HMS-RIC/Teensy-Breakout/README.md

# Teensy-Breakout
Breakout board for 2x Teensys. Fits into 19" rack. Brings many IO pins to front panel BNC connectors. Includes solenoid drivers and comparator-based lick detection with fixed hysteresis.

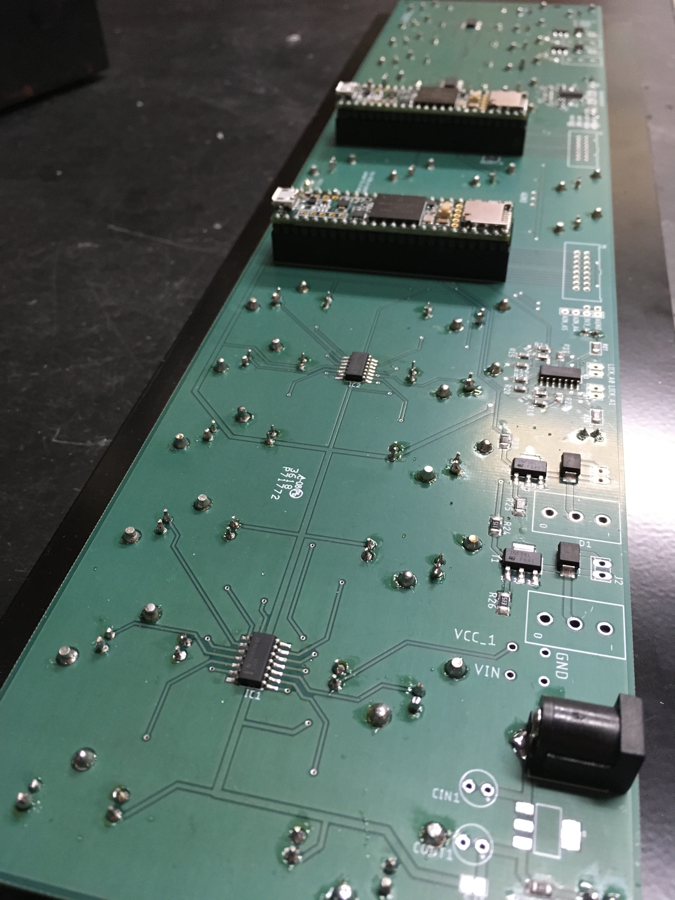
[picture p1: Photos/IMG_0949.JPG]

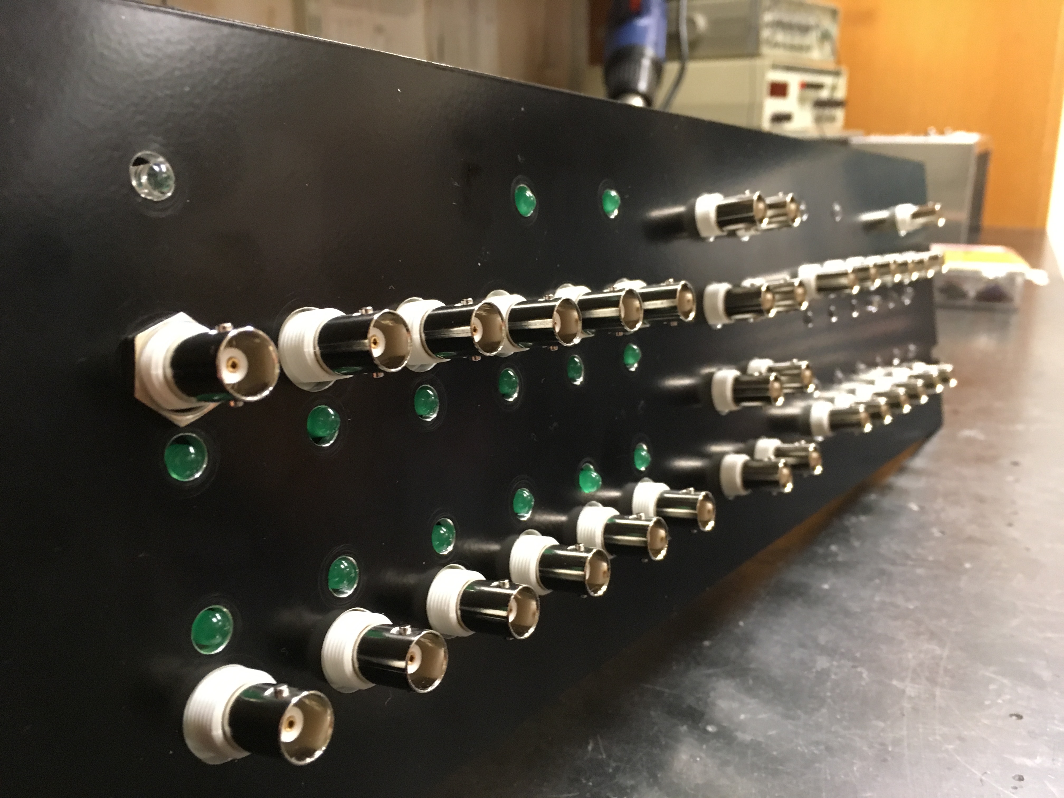
[picture p2: Photos/IMG_0952.JPG]
