HMS-RIC/Teensy-Breakout/TeensyBreakout_PinAssignments_1.pdf

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
1234

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
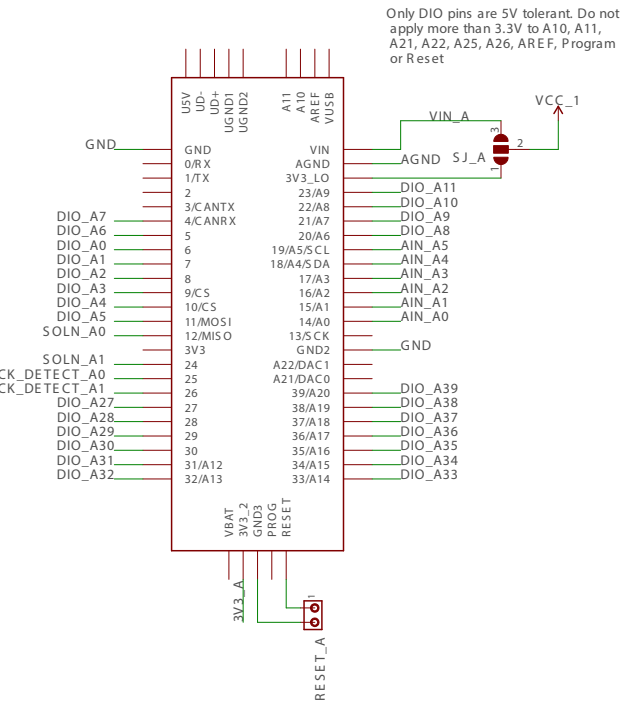
[picture p3: figure]
4 VUS B; UD+ UGND1; UGND2; GND3; VBAT

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
