HMS-RIC/Teensy-Breakout/Photos/IMG_0285.JPG

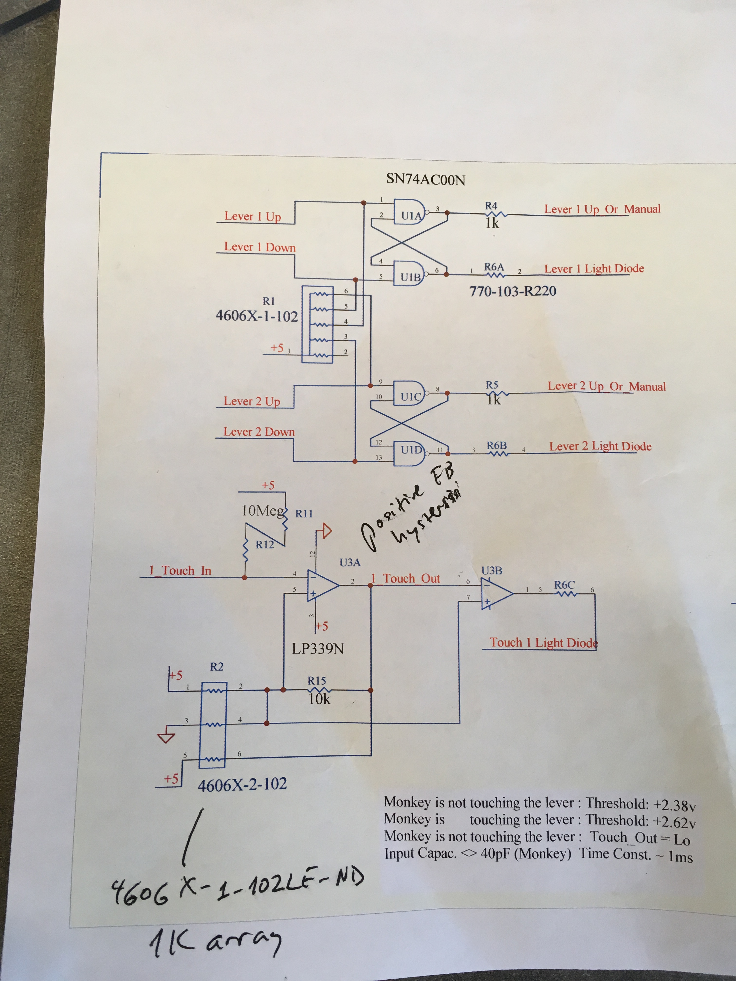
Photos/IMG_0285.JPG
