HMS-RIC/Teensy-Breakout/Photos/IMG_0286.JPG

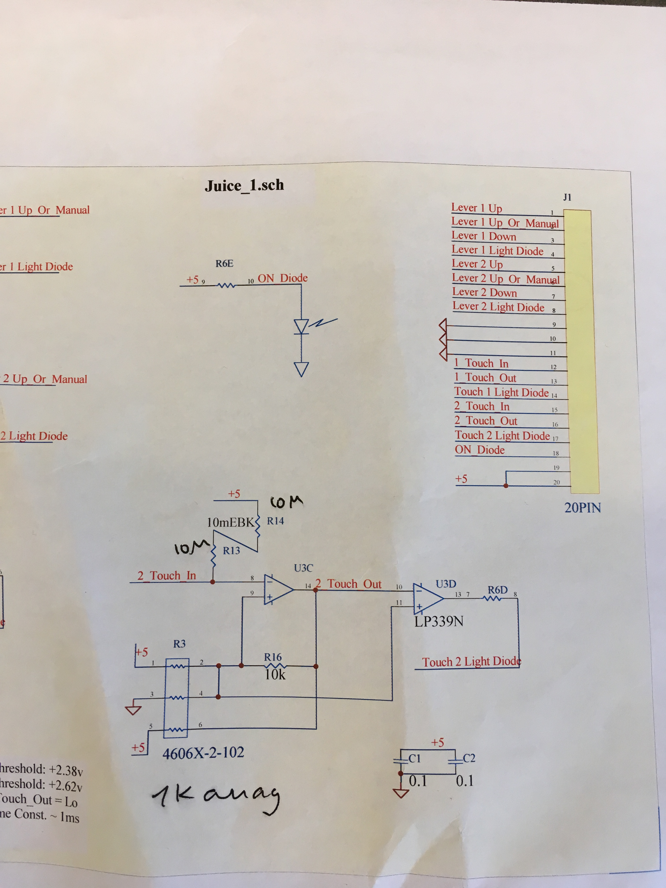
Photos/IMG_0286.JPG
