HMS-RIC/Teensy-Breakout/Photos/IMG_0287.JPG

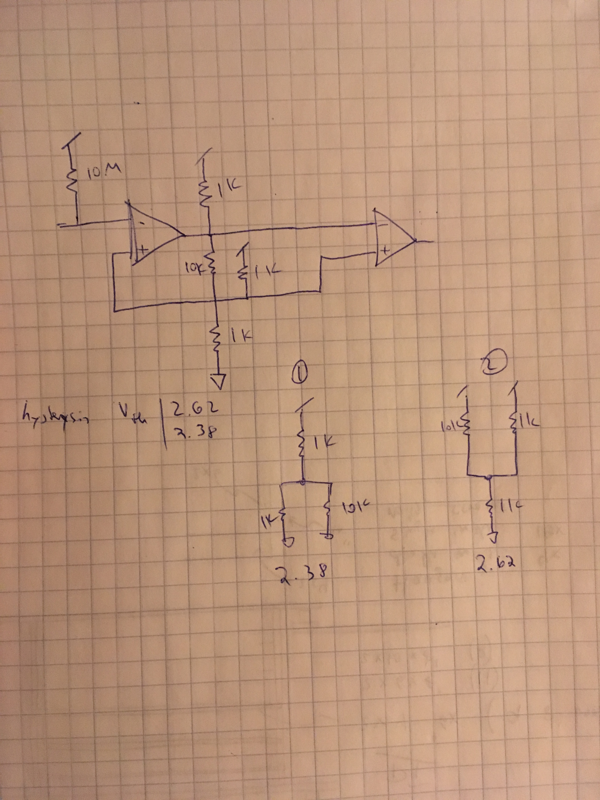
Photos/IMG_0287.JPG
