HMS-RIC/Teensy-Breakout/Photos/IMG_0288.JPG

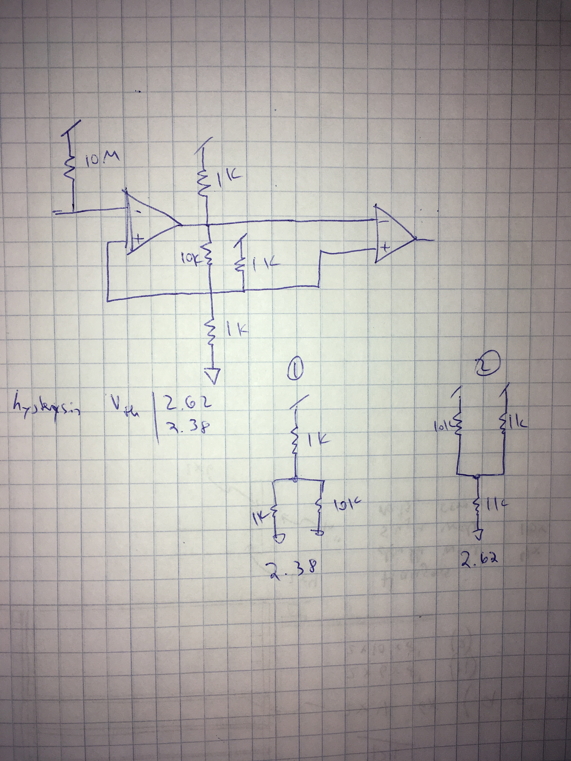
Photos/IMG_0288.JPG
