HMS-RIC/Teensy-Breakout/Photos/IMG_0944.JPG

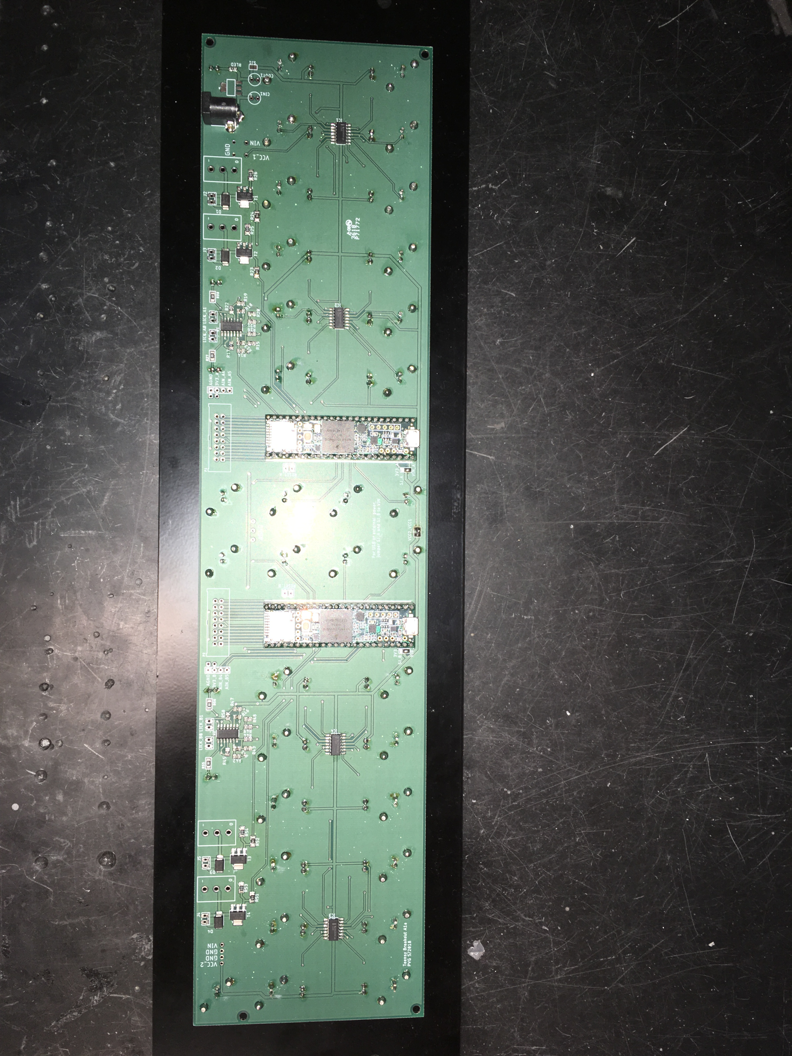
Photos/IMG_0944.JPG
