HMS-RIC/Teensy-Breakout/Photos/IMG_0945.JPG

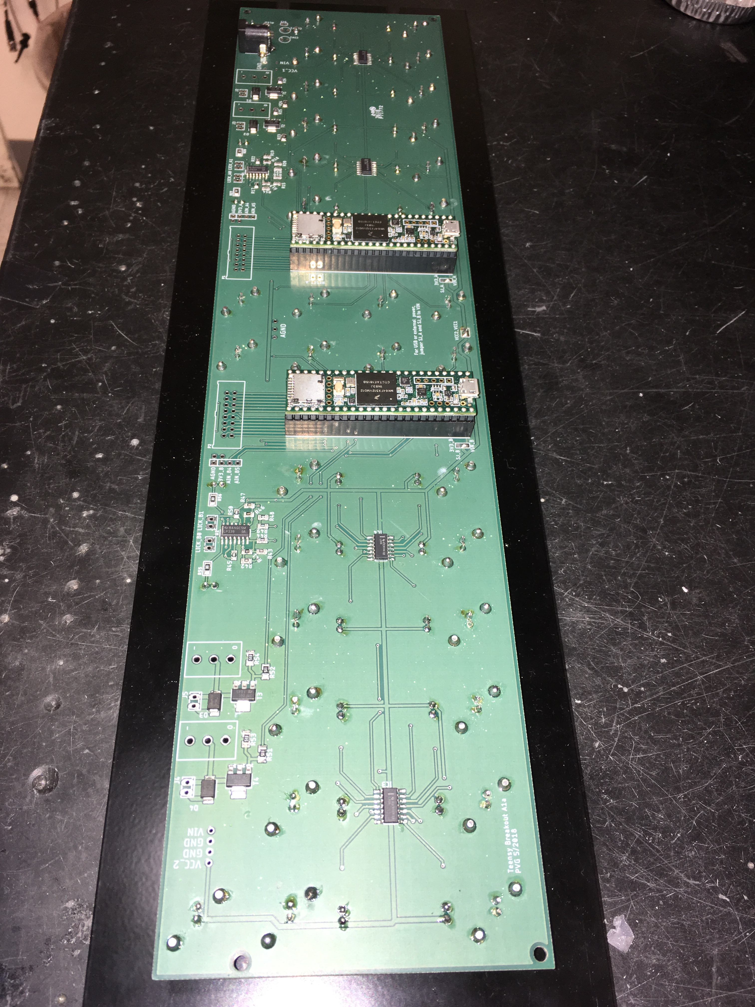
Photos/IMG_0945.JPG
