HMS-RIC/Teensy-Breakout/Photos/IMG_0946.JPG

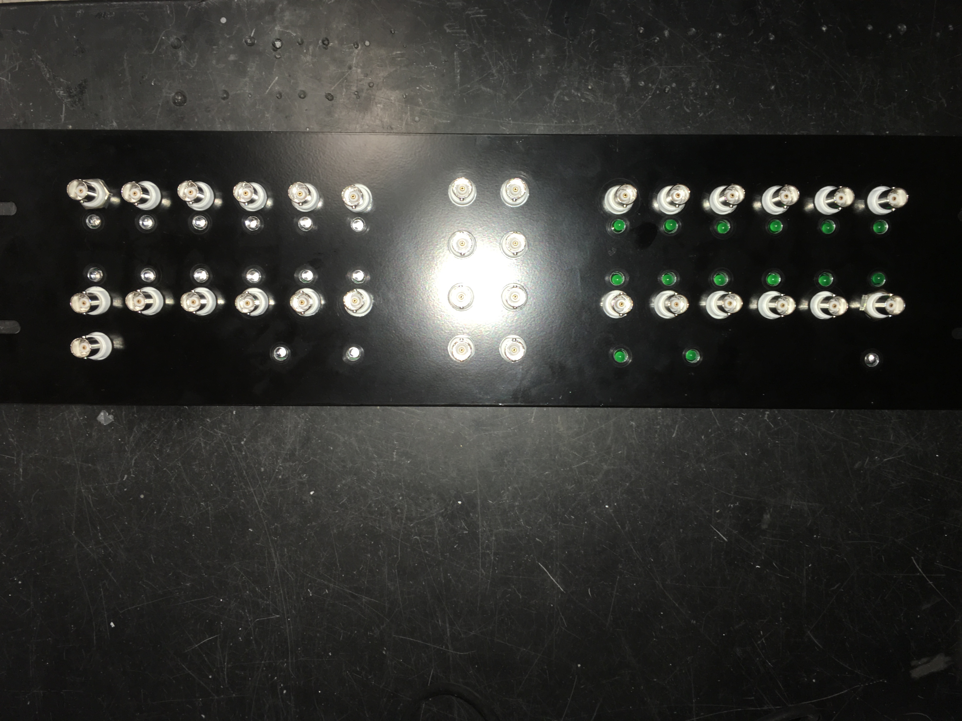
Photos/IMG_0946.JPG
