HMS-RIC/Teensy-Breakout/Photos/IMG_0947.JPG

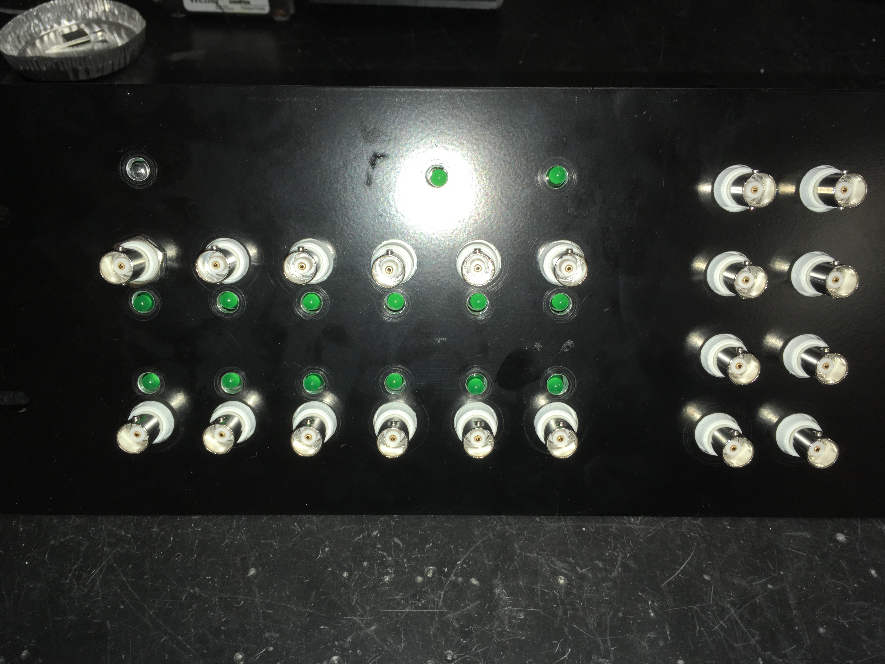
Photos/IMG_0947.JPG
