HMS-RIC/Teensy-Breakout/Photos/IMG_0948.JPG

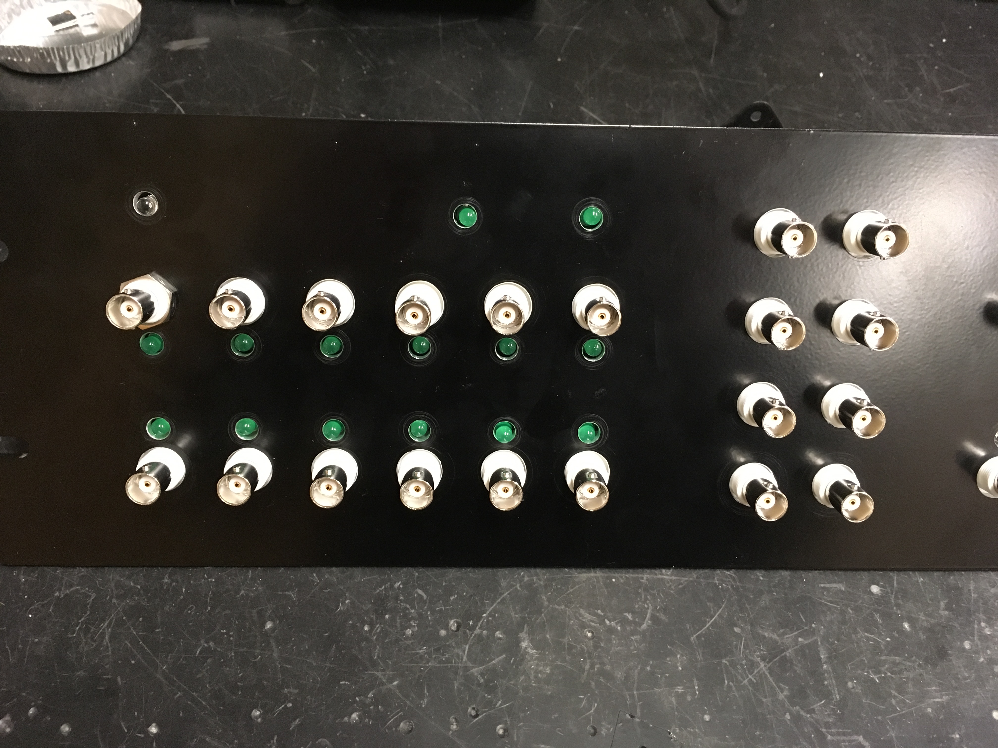
Photos/IMG_0948.JPG
