HMS-RIC/Teensy-Breakout/Photos/IMG_0950.JPG

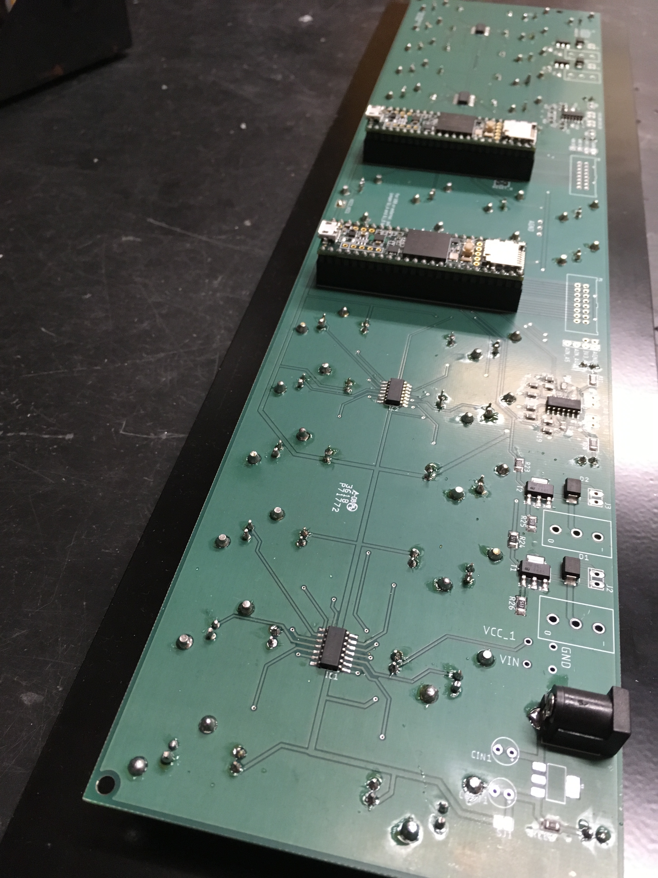
Photos/IMG_0950.JPG
