HMS-RIC/Teensy-Breakout/Photos/IMG_0951.JPG

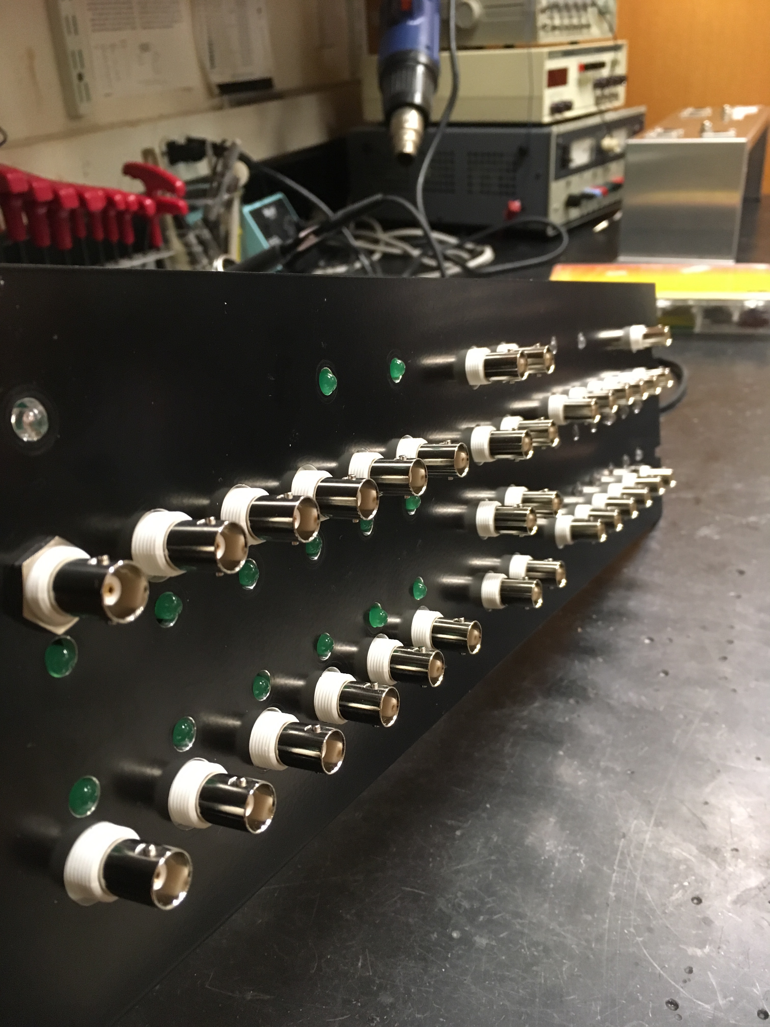
Photos/IMG_0951.JPG
