HMS-RIC/Teensy-Breakout/Photos/IMG_0953.JPG

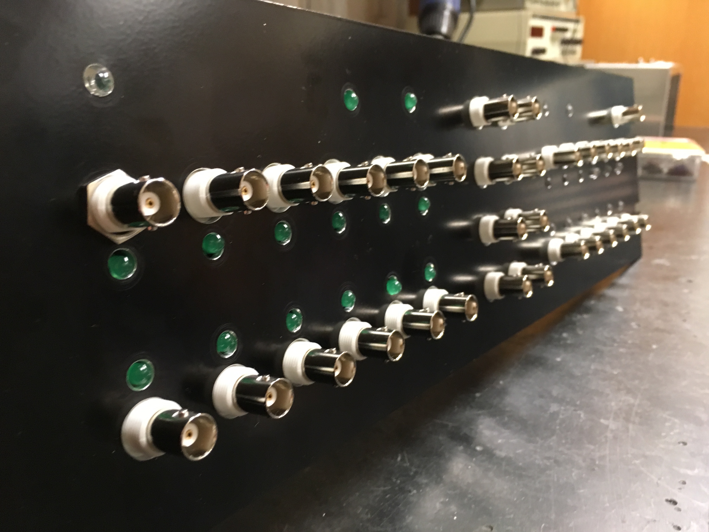
Photos/IMG_0953.JPG
