HMS-RIC/Teensy-Breakout/TeensyBreakout_PinAssignments_1.jpg

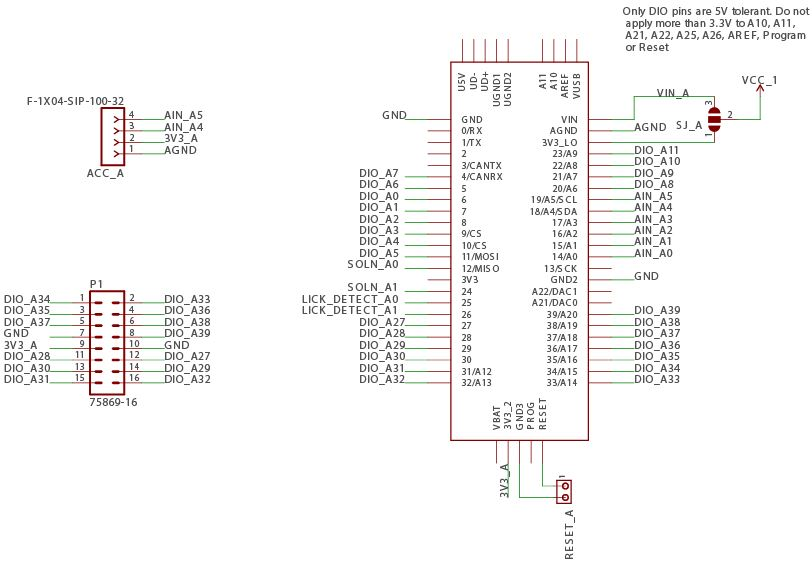
TeensyBreakout_PinAssignments_1.jpg
