HMS-RIC/Teensy-Breakout/TeensyBreakout_Schematic_Alpha1a.pdf

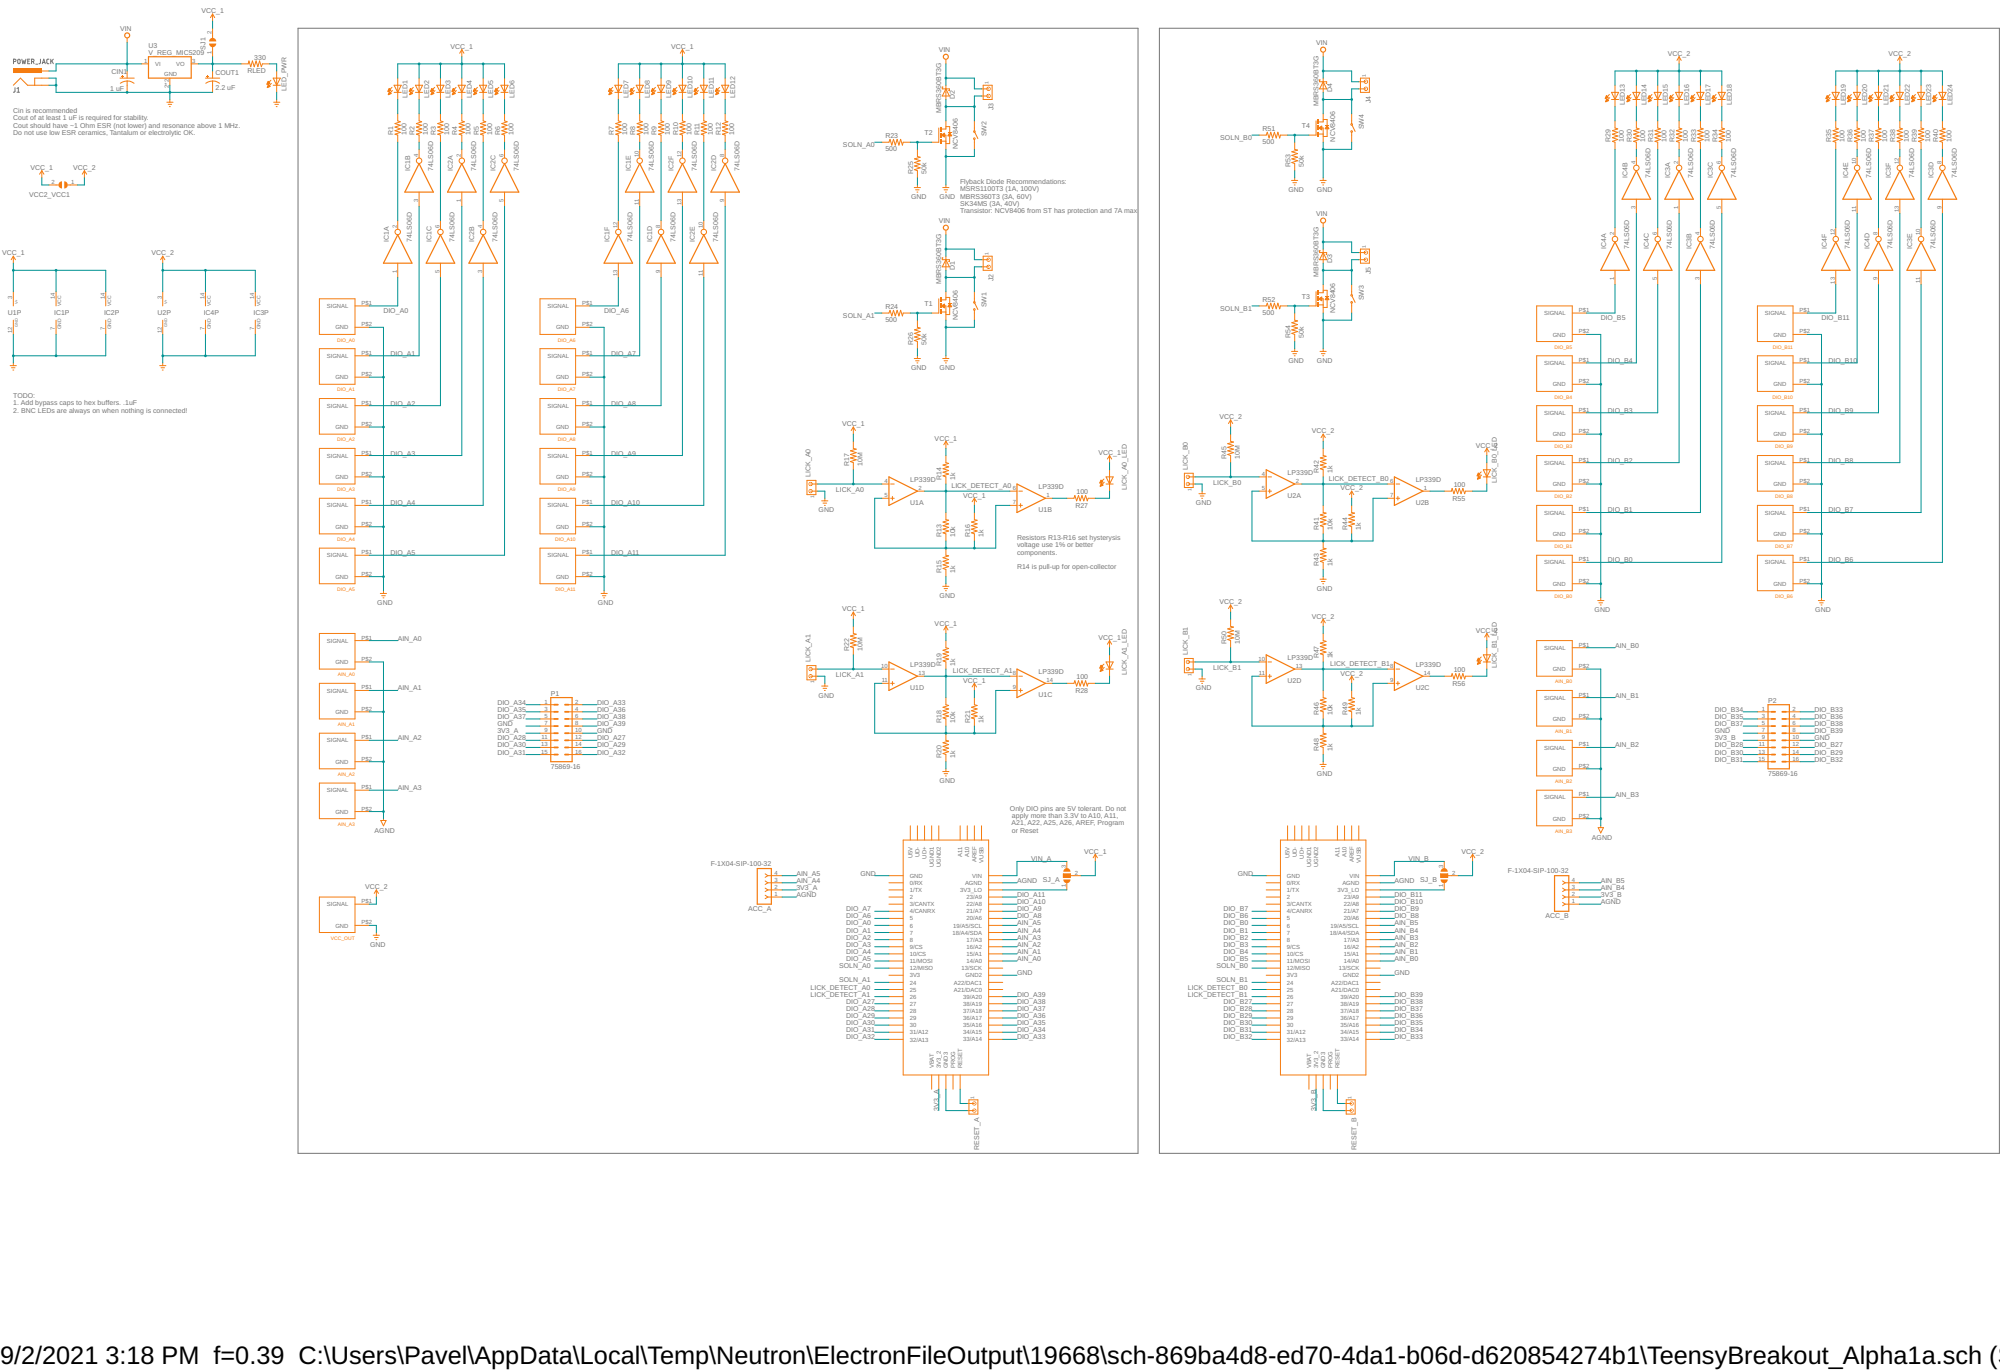
[picture p18: page 1]

TODO: 1. Add bypass caps to hex buffers. .1uF

2. BNC LEDs are always on when nothing is connected!

Resistors R13-R16 set hysterysis
voltage use 1% or better components. R14 is pull-up for open-collector

Only DIO pins are 5V tolerant. Do not apply more than 3.3V to A10, A11, A21, A22, A25, A26, AREF, Program

9/2/2021 3:18 PM f=0.39 C:\Users\Pavel\AppData\Local\Temp\Neutron\ElectronFileOutput\19668\sch-869ba4d8-ed70-4da1-b06d-d620854274b1\TeensyBreakout_Alpha1a.sch (Sheet: 1/1)
