HMS-RIC/Teensy-Breakout/TeensyBreakout_Layout_Bottom_Alpha1a.pdf

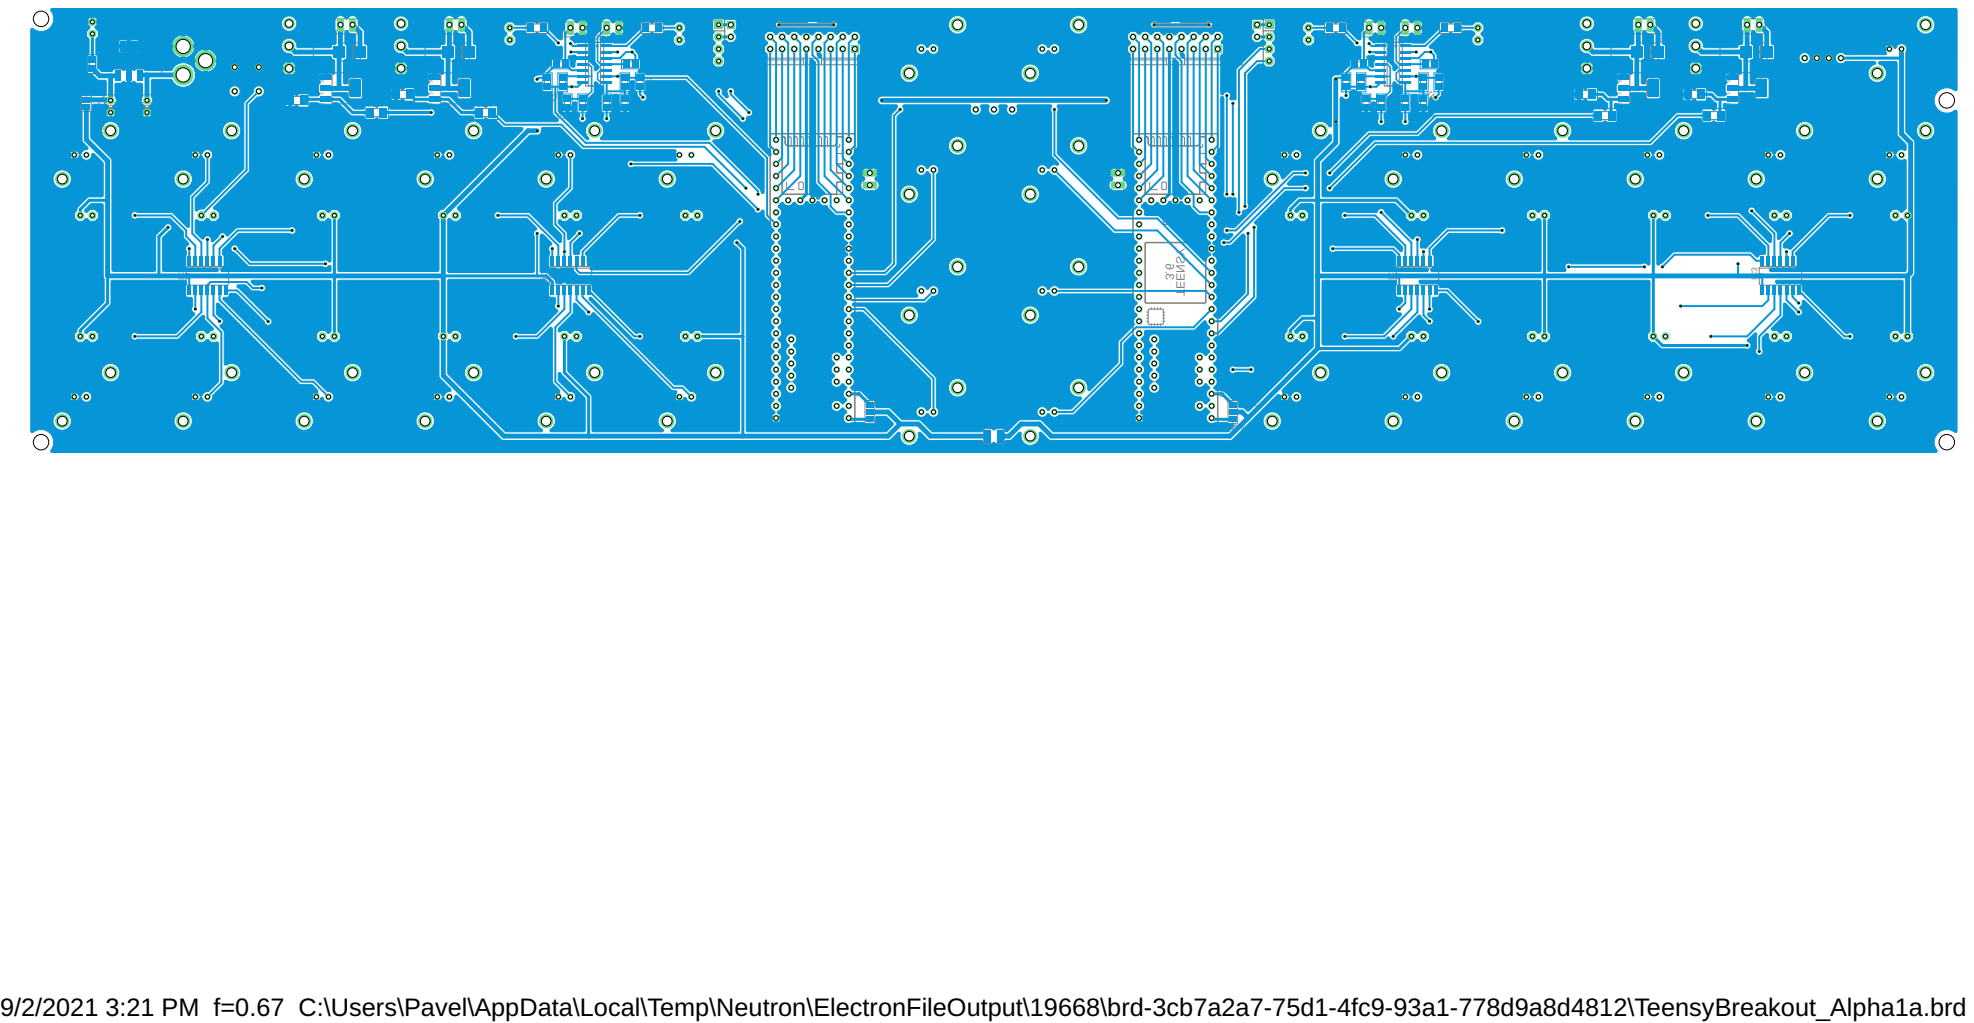
[picture p19: page 1]

9/2/2021 3:21 PM f=0.67 C:\Users\Pavel\AppData\Local\Temp\Neutron\ElectronFileOutput\19668\brd-3cb7a2a7-75d1-4fc9-93a1-778d9a8d4812\TeensyBreakout_Alpha1a.brd
