HMS-RIC/Teensy-Breakout/TeensyBreakout_Layout_Top_Alpha1a.pdf

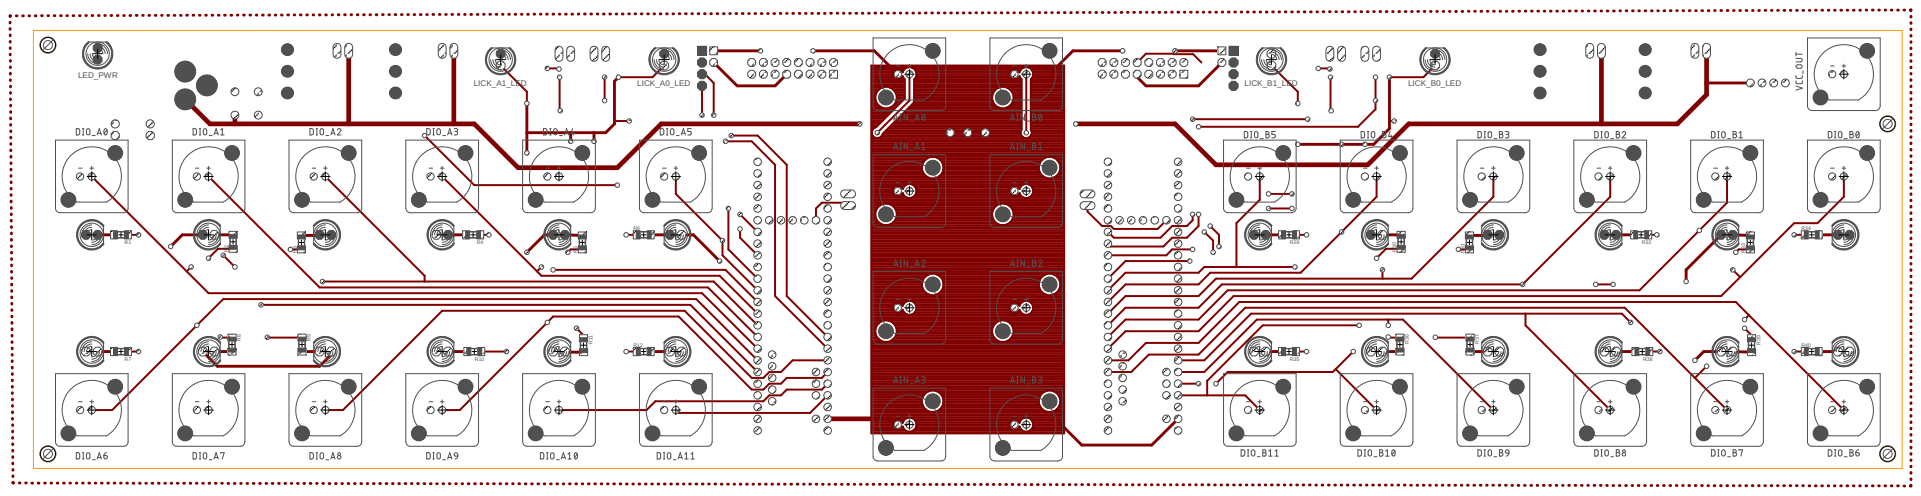
[picture p20: page 1]
