HMS-RIC/Teensy-Breakout/PCB/Alpha2a/BottomSilkscreen.pdf

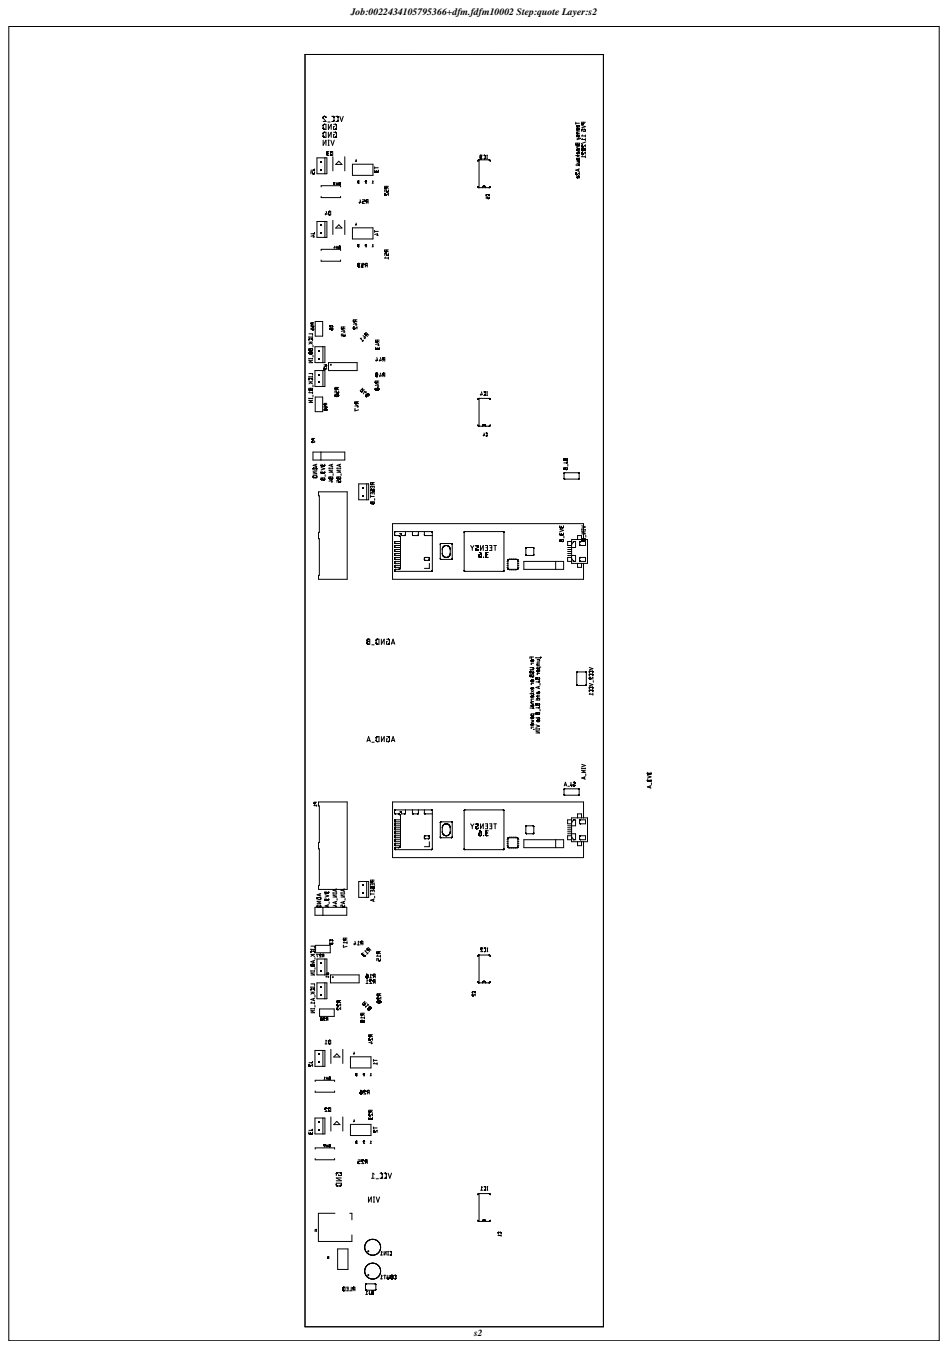
[picture p21: page 1]

Job:0022434105795366+dfm.fdfm10002 Step:quote Layer:s2
