HMS-RIC/Teensy-Breakout/PCB/Alpha2a/TeensyBreakout_Alpha2a.pdf

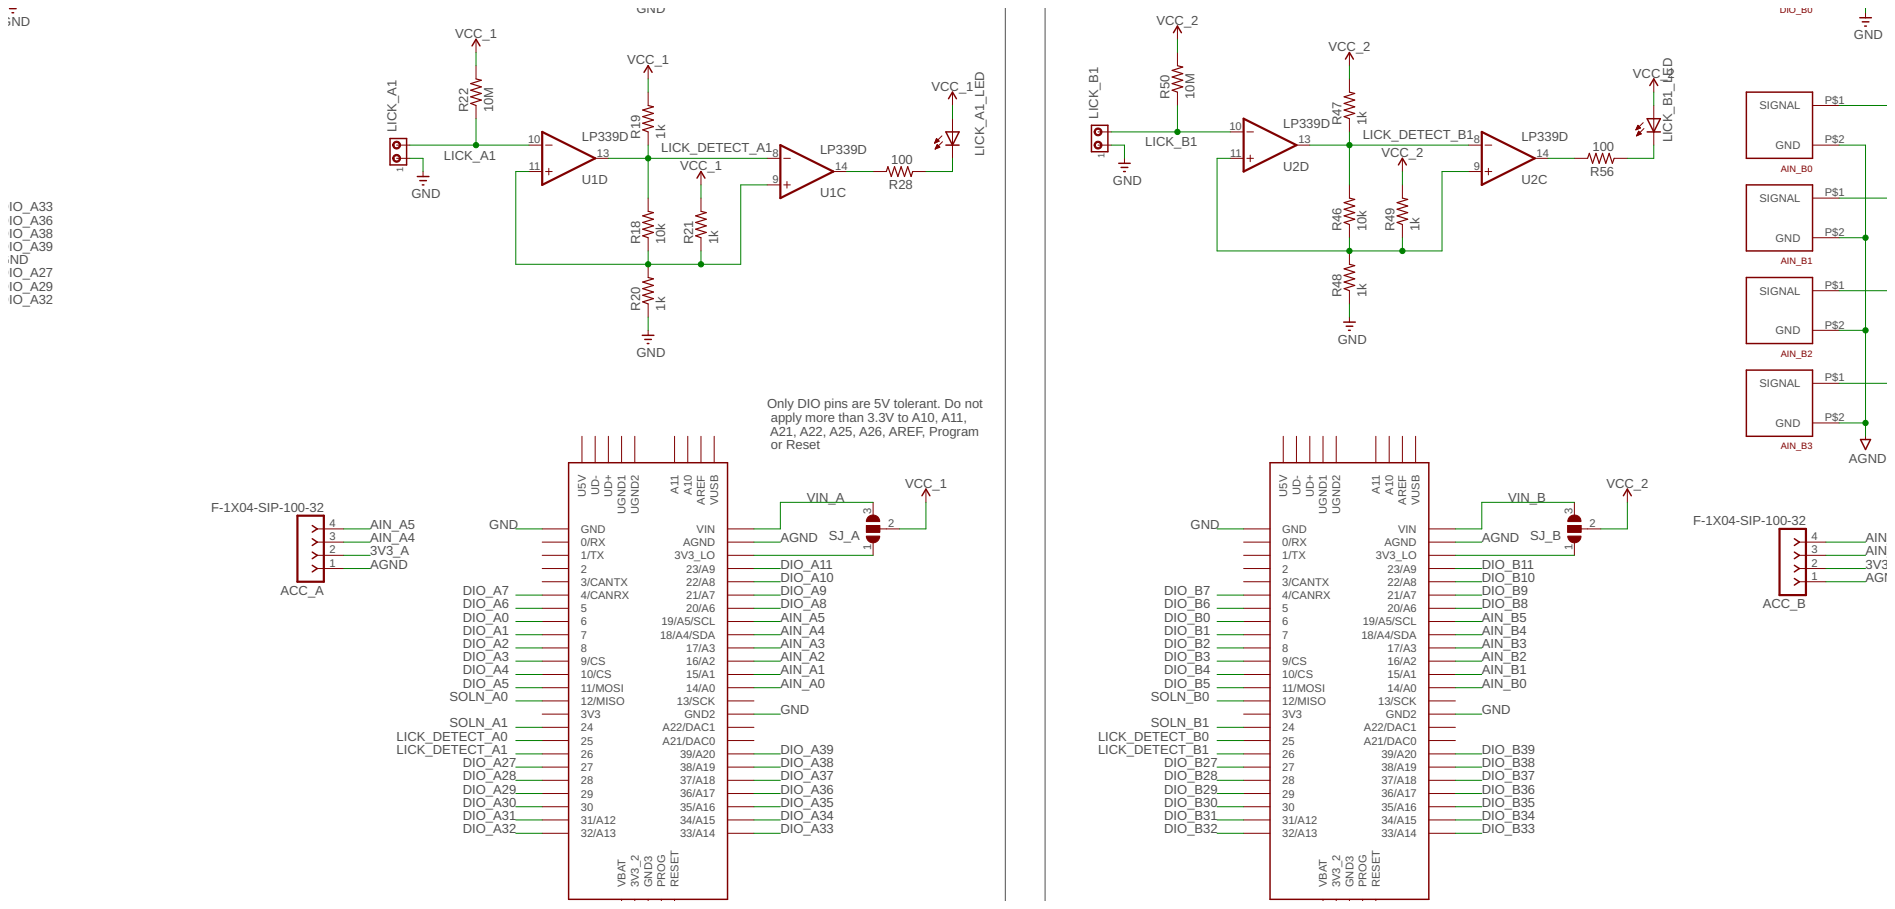
[picture p22: page 1]
