HMS-RIC/Teensy-Breakout/PCB/Alpha2a/TeensyBreakout_Alpha2a.brd

## EAGLE design PCB/Alpha2a/TeensyBreakout_Alpha2a.brd (2024-10-18)

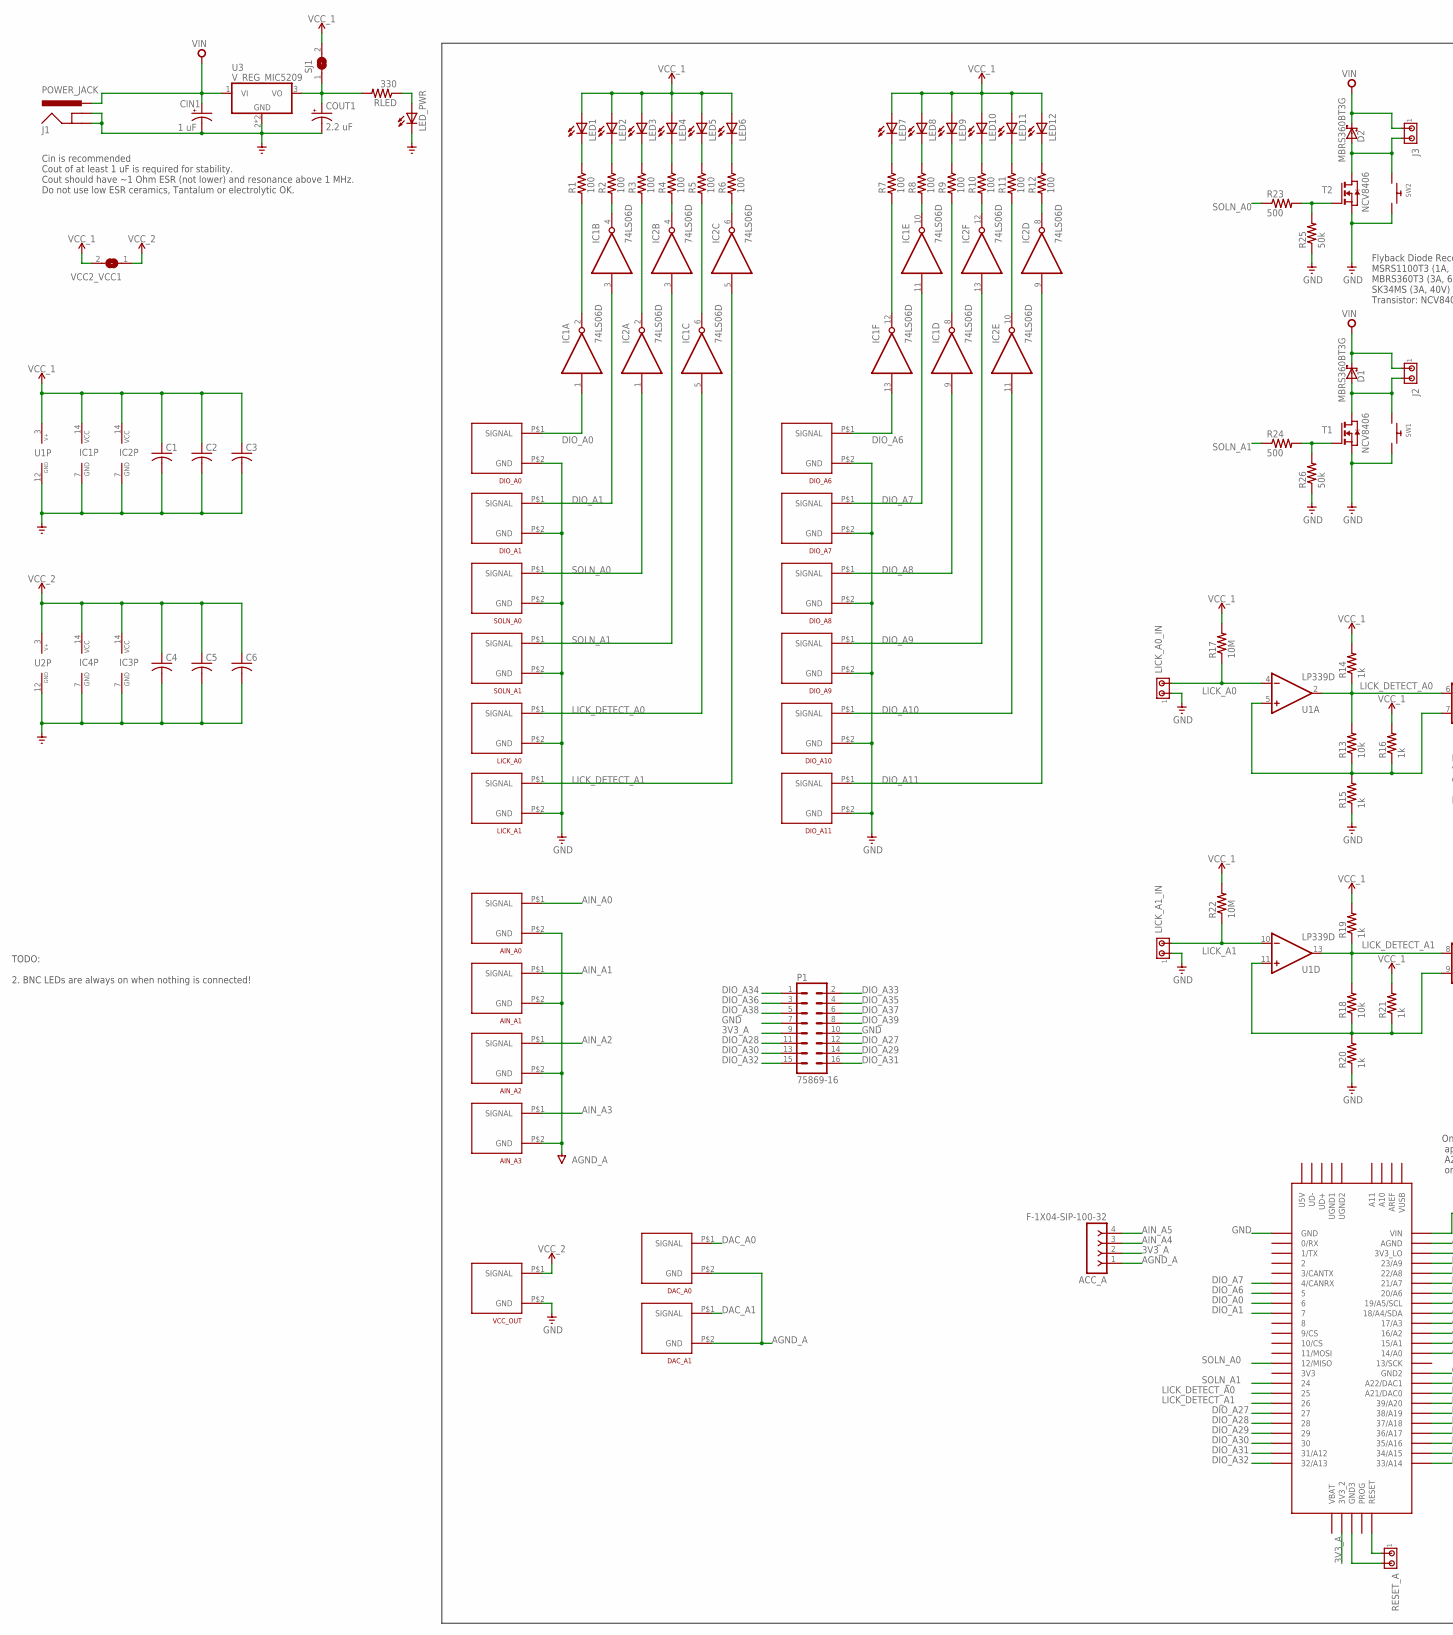
[picture p23: schematic TeensyBreakout_Alpha2a.sch, part in row 1, column 1]

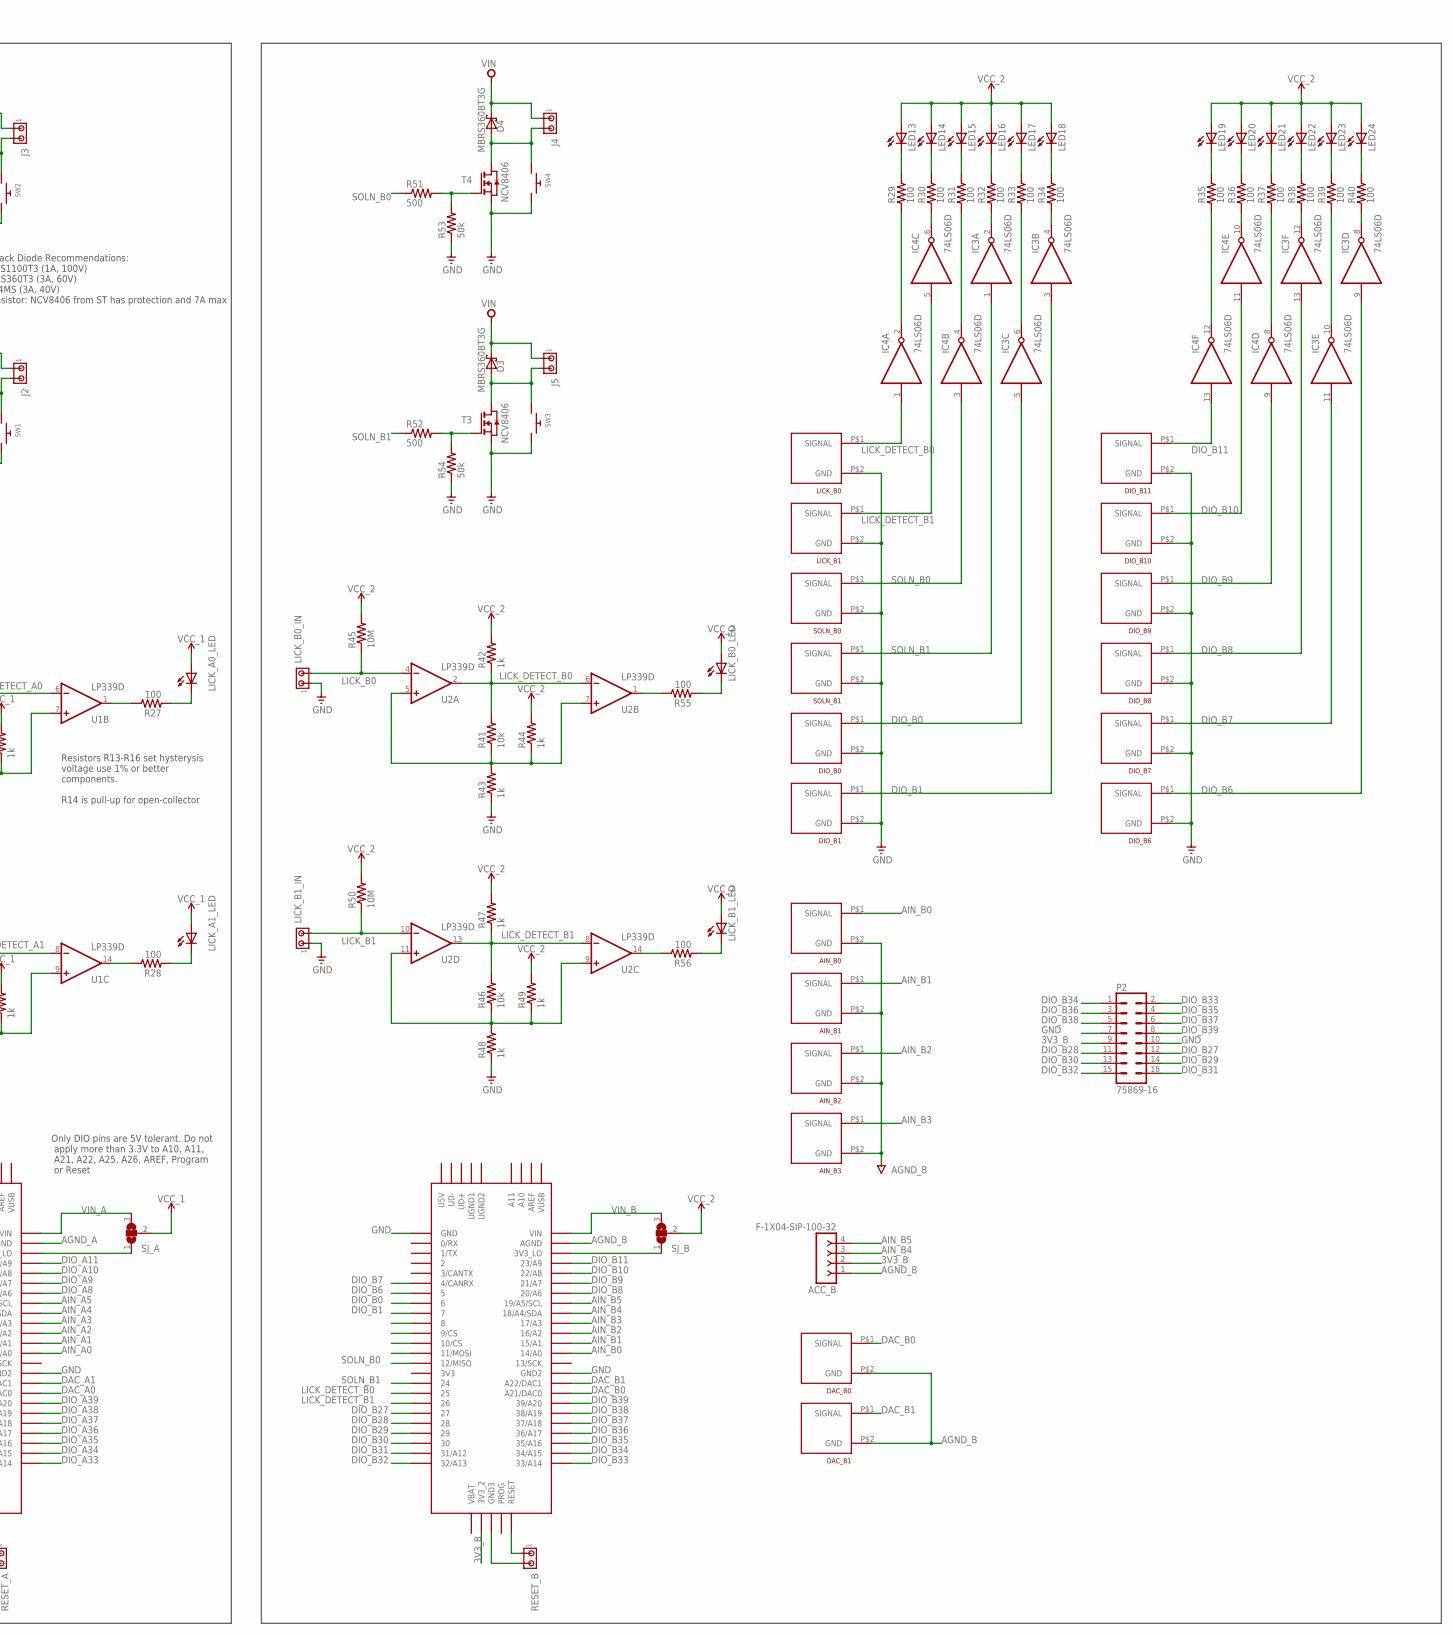
[picture p24: schematic TeensyBreakout_Alpha2a.sch, part in row 1, column 2]

Parts:
ACC_A: F-1X04-SIP-100-32; SIP-100-04-32
ACC_B: F-1X04-SIP-100-32; SIP-100-04-32
AIN_A0, AIN_A1, AIN_A2, AIN_A3: BNC_VERTICAL
AIN_B0, AIN_B1, AIN_B2, AIN_B3: BNC_VERTICAL
C1, C2, C3, C4, C5, C6: C-USC0805K; C0805K
CIN1: 1 uF; E2,5-5
COUT1: 2.2 uF; E2,5-5
D1, D2, D3, D4: MBRS360BT3G; DIODE_SMB
DAC_A0, DAC_A1: BNC_VERTICAL
DAC_B0, DAC_B1: BNC_VERTICAL
DIO_A0, DIO_A1, DIO_A6, DIO_A7, DIO_A8, DIO_A9, DIO_A10, DIO_A11: BNC_VERTICAL
DIO_B0, DIO_B1, DIO_B6, DIO_B7, DIO_B8, DIO_B9, DIO_B10, DIO_B11: BNC_VERTICAL
IC1, IC2, IC3, IC4: 74LS06D; SO14
J1: POWER_JACK; POWER_JACK_PTH
J2, J3, J4, J5: MTA02-100; 10X02MTA
LED1, LED2, LED3, LED4, LED5, LED6, LED7, LED8, LED9, LED10, LED11, LED12, LED13, LED14, LED15, LED16, LED17, LED18, LED19, LED20, LED21, LED22, LED23, LED24: LED5MM
LED_PWR: LED5MM
LICK_A0, LICK_A1: BNC_VERTICAL
LICK_A0_IN, LICK_A1_IN: MTA02-100; 10X02MTA
LICK_A0_LED, LICK_A1_LED: LED5MM
LICK_B0, LICK_B1: BNC_VERTICAL
LICK_B0_IN, LICK_B1_IN: MTA02-100; 10X02MTA
LICK_B0_LED, LICK_B1_LED: LED5MM
P1, P2: 75869-16
R1, R2, R3, R4, R5, R6, R7, R8, R9, R10, R11, R12, R29, R30, R31, R32, R33, R34, R35, R36, R37, R38, R39, R40: 100; R1206MP
R13, R18, R41, R46: 10k; M0805
R14, R15, R16, R19, R20, R21, R42, R43, R44, R47, R48, R49: 1k; M0805
R17, R22, R45, R50: 10M; M0805
R23, R24, R51, R52: 500; M1206
R25, R26, R53, R54: 50k; M1206
R27, R28, R55, R56: 100; R1206
RESET_A: MTA02-100; 10X02MTA
RESET_B: MTA02-100; 10X02MTA
RLED: 330; R0805
SJ1: SJ
SJ_A: SJ2W; SJ_2
SJ_B: SJ2W; SJ_2
SOLN_A0, SOLN_A1: BNC_VERTICAL
SOLN_B0, SOLN_B1: BNC_VERTICAL
SW1, SW2, SW3, SW4: SWITCH_PUSHBUTTONEVQ-PE; TACT_PANA-EVQ
T1, T2, T3, T4: NCV8406; SOT223
TEENSY_A: TEENSY_3.5/3.6
TEENSY_B: TEENSY_3.5/3.6
U1, U2: LP339D; SO14
U3: V_REG_MIC5209; SOT-223
VCC2_VCC1: SJW
VCC_OUT: BNC_VERTICAL

Connections:
3V3_A: ACC_A.2, P1.9, TEENSY_A.3V3_2
3V3_B: ACC_B.2, P2.9, TEENSY_B.3V3_2
AGND_A: ACC_A.1, AIN_A0.P$2 (GND), AIN_A1.P$2 (GND), AIN_A2.P$2 (GND), AIN_A3.P$2 (GND), DAC_A0.P$2 (GND), DAC_A1.P$2 (GND), TEENSY_A.AGND
AGND_B: ACC_B.1, AIN_B0.P$2 (GND), AIN_B1.P$2 (GND), AIN_B2.P$2 (GND), AIN_B3.P$2 (GND), DAC_B0.P$2 (GND), DAC_B1.P$2 (GND), TEENSY_B.AGND
AIN_A0: AIN_A0.P$1 (SIGNAL), TEENSY_A.14/A0
AIN_A1: AIN_A1.P$1 (SIGNAL), TEENSY_A.15/A1
AIN_A2: AIN_A2.P$1 (SIGNAL), TEENSY_A.16/A2
AIN_A3: AIN_A3.P$1 (SIGNAL), TEENSY_A.17/A3
AIN_A4: ACC_A.3, TEENSY_A.18/A4/SDA
AIN_A5: ACC_A.4, TEENSY_A.19/A5/SCL
AIN_B0: AIN_B0.P$1 (SIGNAL), TEENSY_B.14/A0
AIN_B1: AIN_B1.P$1 (SIGNAL), TEENSY_B.15/A1
AIN_B2: AIN_B2.P$1 (SIGNAL), TEENSY_B.16/A2
AIN_B3: AIN_B3.P$1 (SIGNAL), TEENSY_B.17/A3
AIN_B4: ACC_B.3, TEENSY_B.18/A4/SDA
AIN_B5: ACC_B.4, TEENSY_B.19/A5/SCL
DAC_A0: DAC_A0.P$1 (SIGNAL), TEENSY_A.21/DAC0 (A21/DAC0)
DAC_A1: DAC_A1.P$1 (SIGNAL), TEENSY_A.A22/DAC1
DAC_B0: DAC_B0.P$1 (SIGNAL), TEENSY_B.21/DAC0 (A21/DAC0)
DAC_B1: DAC_B1.P$1 (SIGNAL), TEENSY_B.A22/DAC1
DIO_A0: DIO_A0.P$1 (SIGNAL), IC1.1 (I), TEENSY_A.6
DIO_A1: DIO_A1.P$1 (SIGNAL), IC1.3 (I), TEENSY_A.7
DIO_A6: DIO_A6.P$1 (SIGNAL), IC1.13 (I), TEENSY_A.5
DIO_A7: DIO_A7.P$1 (SIGNAL), IC1.11 (I), TEENSY_A.4/CANRX
DIO_A8: DIO_A8.P$1 (SIGNAL), IC1.9 (I), TEENSY_A.20/A6
DIO_A9: DIO_A9.P$1 (SIGNAL), IC2.13 (I), TEENSY_A.21/A7
DIO_A10: DIO_A10.P$1 (SIGNAL), IC2.11 (I), TEENSY_A.22/A8
DIO_A11: DIO_A11.P$1 (SIGNAL), IC2.9 (I), TEENSY_A.23/A9
DIO_A27: P1.12, TEENSY_A.27
DIO_A28: P1.11, TEENSY_A.28
DIO_A29: P1.14, TEENSY_A.29
DIO_A30: P1.13, TEENSY_A.30
DIO_A31: P1.16, TEENSY_A.31/A12
DIO_A32: P1.15, TEENSY_A.32/A13
DIO_A33: P1.2, TEENSY_A.33/A14
DIO_A34: P1.1, TEENSY_A.34/A15
DIO_A35: P1.4, TEENSY_A.35/A16
DIO_A36: P1.3, TEENSY_A.36/A17
DIO_A37: P1.6, TEENSY_A.37/A18
DIO_A38: P1.5, TEENSY_A.38/A19
DIO_A39: P1.8, TEENSY_A.39/A20
DIO_B0: DIO_B0.P$1 (SIGNAL), IC3.5 (I), TEENSY_B.6
DIO_B1: DIO_B1.P$1 (SIGNAL), IC3.3 (I), TEENSY_B.7
DIO_B6: DIO_B6.P$1 (SIGNAL), IC3.9 (I), TEENSY_B.5
DIO_B7: DIO_B7.P$1 (SIGNAL), IC3.11 (I), TEENSY_B.4/CANRX
DIO_B8: DIO_B8.P$1 (SIGNAL), IC3.13 (I), TEENSY_B.20/A6
DIO_B9: DIO_B9.P$1 (SIGNAL), IC4.9 (I), TEENSY_B.21/A7
DIO_B10: DIO_B10.P$1 (SIGNAL), IC4.11 (I), TEENSY_B.22/A8
DIO_B11: DIO_B11.P$1 (SIGNAL), IC4.13 (I), TEENSY_B.23/A9
DIO_B27: P2.12, TEENSY_B.27
DIO_B28: P2.11, TEENSY_B.28
DIO_B29: P2.14, TEENSY_B.29
DIO_B30: P2.13, TEENSY_B.30
DIO_B31: P2.16, TEENSY_B.31/A12
DIO_B32: P2.15, TEENSY_B.32/A13
DIO_B33: P2.2, TEENSY_B.33/A14
DIO_B34: P2.1, TEENSY_B.34/A15
DIO_B35: P2.4, TEENSY_B.35/A16
DIO_B36: P2.3, TEENSY_B.36/A17
DIO_B37: P2.6, TEENSY_B.37/A18
DIO_B38: P2.5, TEENSY_B.38/A19
DIO_B39: P2.8, TEENSY_B.39/A20
GND: C1.2, C2.2, C3.2, C4.2, C5.2, C6.2, CIN1.-, COUT1.-, DIO_A0.P$2 (GND), DIO_A1.P$2 (GND), DIO_A6.P$2 (GND), DIO_A7.P$2 (GND), DIO_A8.P$2 (GND), DIO_A9.P$2 (GND), DIO_A10.P$2 (GND), DIO_A11.P$2 (GND), DIO_B0.P$2 (GND), DIO_B1.P$2 (GND), DIO_B6.P$2 (GND), DIO_B7.P$2 (GND), DIO_B8.P$2 (GND), DIO_B9.P$2 (GND), DIO_B10.P$2 (GND), DIO_B11.P$2 (GND), IC1.7 (GND), IC2.7 (GND), IC3.7 (GND), IC4.7 (GND), J1.GND, J1.GNDBREAK, LED_PWR.K (C), LICK_A0.P$2 (GND), LICK_A0_IN.1, LICK_A1.P$2 (GND), LICK_A1_IN.1, LICK_B0.P$2 (GND), LICK_B0_IN.1, LICK_B1.P$2 (GND), LICK_B1_IN.1, P1.7, P1.10, P2.7, P2.10, R15.1, R20.1, R25.1, R26.1, R43.1, R48.1, R53.1, R54.1, RESET_A.2, RESET_B.2, SOLN_A0.P$2 (GND), SOLN_A1.P$2 (GND), SOLN_B0.P$2 (GND), SOLN_B1.P$2 (GND), SW1.P$2, SW2.P$2, SW3.P$2, SW4.P$2, T1.3 (S), T2.3 (S), T3.3 (S), T4.3 (S), TEENSY_A.GND, TEENSY_A.GND2, TEENSY_A.GND3, TEENSY_B.GND, TEENSY_B.GND2, TEENSY_B.GND3, U1.12 (GND), U2.12 (GND), U3.2 (GND), U3.4 (GND), VCC_OUT.P$2 (GND)
LICK_A0: LICK_A0_IN.2, R17.1, U1.4 (-IN)
LICK_A1: LICK_A1_IN.2, R22.1, U1.10 (-IN)
LICK_B0: LICK_B0_IN.2, R45.1, U2.4 (-IN)
LICK_B1: LICK_B1_IN.2, R50.1, U2.10 (-IN)
LICK_DETECT_A0: IC1.5 (I), LICK_A0.P$1 (SIGNAL), R13.2, R14.1, TEENSY_A.25, U1.2 (OUT), U1.6 (-IN)
LICK_DETECT_A1: IC2.5 (I), LICK_A1.P$1 (SIGNAL), R18.2, R19.1, TEENSY_A.26, U1.8 (-IN), U1.13 (OUT)
LICK_DETECT_B0: IC4.1 (I), LICK_B0.P$1 (SIGNAL), R41.2, R42.1, TEENSY_B.25, U2.2 (OUT), U2.6 (-IN)
LICK_DETECT_B1: IC4.5 (I), LICK_B1.P$1 (SIGNAL), R46.2, R47.1, TEENSY_B.26, U2.8 (-IN), U2.13 (OUT)
unnamed: IC1.2 (O), R1.1
unnamed: IC1.4 (O), R2.1
unnamed: IC2.4 (O), R4.1
unnamed: IC2.2 (O), R3.1
unnamed: IC1.6 (O), R5.1
unnamed: IC2.6 (O), R6.1
unnamed: LED1.K (C), R1.2
unnamed: LED2.K (C), R2.2
unnamed: LED3.K (C), R3.2
unnamed: LED4.K (C), R4.2
unnamed: LED5.K (C), R5.2
unnamed: LED6.K (C), R6.2
unnamed: R18.1, R20.2, R21.1, U1.9 (+IN), U1.11 (+IN)
unnamed: LED_PWR.A, RLED.1
unnamed: IC1.12 (O), R7.1
unnamed: IC1.10 (O), R8.1
unnamed: IC1.8 (O), R9.1
unnamed: IC2.12 (O), R10.1
unnamed: IC2.10 (O), R11.1
unnamed: IC2.8 (O), R12.1
unnamed: LED7.K (C), R7.2
unnamed: LED8.K (C), R8.2
unnamed: LED9.K (C), R9.2
unnamed: LED10.K (C), R10.2
unnamed: LED11.K (C), R11.2
unnamed: LED12.K (C), R12.2
unnamed: R13.1, R15.2, R16.1, U1.5 (+IN), U1.7 (+IN)
unnamed: SJ_A.1, TEENSY_A.3V3_LO
unnamed: COUT1.+, RLED.2, SJ1.1, U3.3 (VO)
unnamed: R23.2, R25.2, T2.1 (G)
unnamed: R27.2, U1.1 (OUT)
unnamed: R24.2, R26.2, T1.1 (G)
unnamed: LICK_A0_LED.K (C), R27.1
unnamed: IC4.4 (O), R31.1
unnamed: IC4.6 (O), R30.1
unnamed: IC3.6 (O), R33.1
unnamed: LICK_A1_LED.K (C), R28.1
unnamed: IC3.4 (O), R34.1
unnamed: R28.2, U1.14 (OUT)
unnamed: SJ_B.1, TEENSY_B.3V3_LO
unnamed: IC3.2 (O), R32.1
unnamed: LED14.K (C), R30.2
unnamed: LED15.K (C), R31.2
unnamed: LED16.K (C), R32.2
unnamed: LED17.K (C), R33.2
unnamed: LED18.K (C), R34.2
unnamed: IC4.12 (O), R35.1
unnamed: IC4.10 (O), R36.1
unnamed: IC4.8 (O), R37.1
unnamed: IC3.12 (O), R38.1
unnamed: IC3.10 (O), R39.1
unnamed: IC3.8 (O), R40.1
unnamed: LED19.K (C), R35.2
unnamed: LED20.K (C), R36.2
unnamed: LED21.K (C), R37.2
unnamed: LED22.K (C), R38.2
unnamed: LED23.K (C), R39.2
unnamed: LED24.K (C), R40.2
unnamed: R51.2, R53.2, T4.1 (G)
unnamed: R52.2, R54.2, T3.1 (G)
unnamed: IC4.2 (O), R29.1
unnamed: LED13.K (C), R29.2
unnamed: R41.1, R43.2, R44.1, U2.5 (+IN), U2.7 (+IN)
unnamed: R46.1, R48.2, R49.1, U2.9 (+IN), U2.11 (+IN)
unnamed: R55.2, U2.1 (OUT)
unnamed: LICK_B0_LED.K (C), R55.1
unnamed: LICK_B1_LED.K (C), R56.1
unnamed: R56.2, U2.14 (OUT)
RESET_A: RESET_A.1, TEENSY_A.RESET
RESET_B: RESET_B.1, TEENSY_B.RESET
SOLN_A0: IC2.1 (I), R23.1, SOLN_A0.P$1 (SIGNAL), TEENSY_A.12/MISO
SOLN_A1: IC2.3 (I), R24.1, SOLN_A1.P$1 (SIGNAL), TEENSY_A.24
SOLN_B0: IC4.3 (I), R51.1, SOLN_B0.P$1 (SIGNAL), TEENSY_B.12/MISO
SOLN_B1: IC3.1 (I), R52.1, SOLN_B1.P$1 (SIGNAL), TEENSY_B.24
VCC_1: C1.1, C2.1, C3.1, IC1.14 (VCC), IC2.14 (VCC), LED1.A, LED2.A, LED3.A, LED4.A, LED5.A, LED6.A, LED7.A, LED8.A, LED9.A, LED10.A, LED11.A, LED12.A, LICK_A0_LED.A, LICK_A1_LED.A, R14.2, R16.2, R17.2, R19.2, R21.2, R22.2, SJ1.2, SJ_A.2, U1.3 (V+), VCC2_VCC1.2
VCC_2: C4.1, C5.1, C6.1, IC3.14 (VCC), IC4.14 (VCC), LED13.A, LED14.A, LED15.A, LED16.A, LED17.A, LED18.A, LED19.A, LED20.A, LED21.A, LED22.A, LED23.A, LED24.A, LICK_B0_LED.A, LICK_B1_LED.A, R42.2, R44.2, R45.2, R47.2, R49.2, R50.2, SJ_B.2, U2.3 (V+), VCC2_VCC1.1, VCC_OUT.P$1 (SIGNAL)
VIN: CIN1.+, D1.C (A), D2.C (A), D3.C (A), D4.C (A), J1.PWR, J2.1, J3.1, J4.1, J5.1, U3.1 (VI)
VIN_A: SJ_A.3, TEENSY_A.VIN
VIN_B: SJ_B.3, TEENSY_B.VIN
VOUT-2: D1.A (C), J2.2, SW1.P$1, T1.2 (D), T1.4 (D)
VOUT-3: D2.A (C), J3.2, SW2.P$1, T2.2 (D), T2.4 (D)
VOUT-5: D4.A (C), J4.2, SW4.P$1, T4.2 (D), T4.4 (D)
VOUT-6: D3.A (C), J5.2, SW3.P$1, T3.2 (D), T3.4 (D)

Notes on the sheet:
Cin is recommended Cout of at least 1 uF is required for stability. Cout should have ~1 Ohm ESR (not lower) and resonance above 1 MHz. Do not use low ESR ceramics, Tantalum or electrolytic OK.
Flyback Diode Recommendations: MSRS1100T3 (1A, 100V) MBRS360T3 (3A, 60V) SK34MS (3A, 40V) Transistor: NCV8406 from ST has protection and 7A max
Resistors R13-R16 set hysterysis voltage use 1% or better components. R14 is pull-up for open-collector
Only DIO pins are 5V tolerant. Do not apply more than 3.3V to A10, A11, A21, A22, A25, A26, AREF, Program or Reset
TODO: 2. BNC LEDs are always on when nothing is connected!

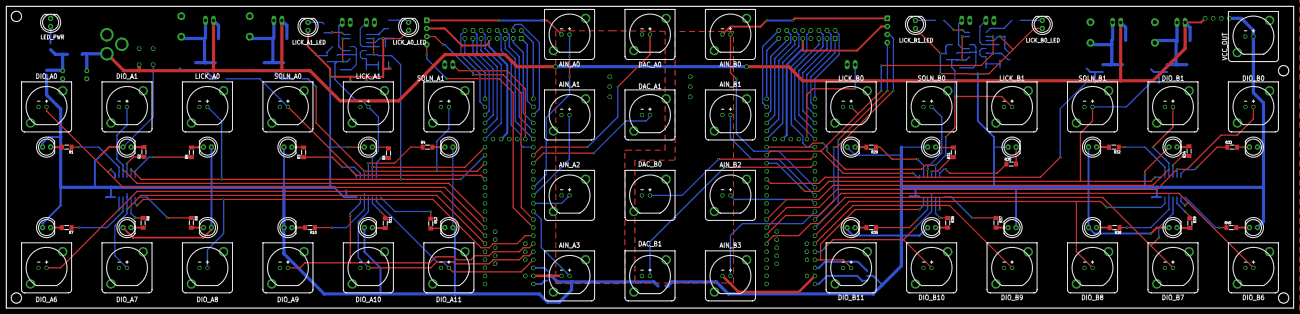
[picture p25: board TeensyBreakout_Alpha2a.brd from above]

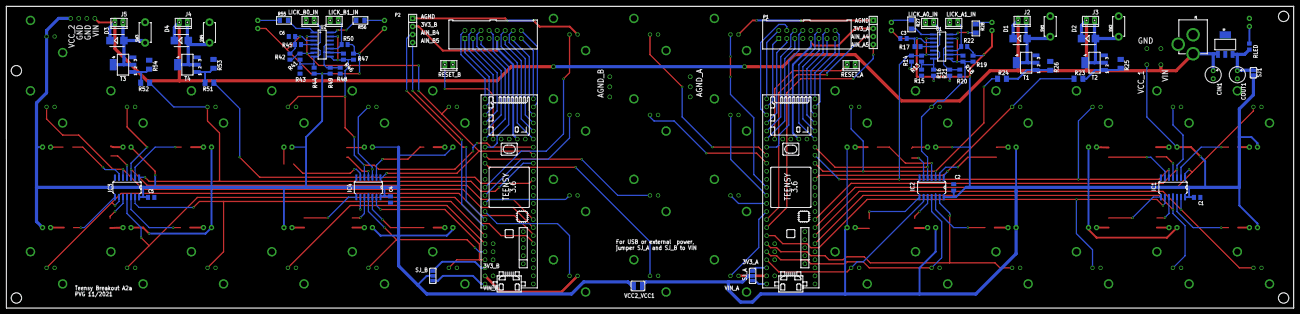
[picture p26: board TeensyBreakout_Alpha2a.brd from below]

Board: 2 copper layers, 406.4 x 95.2 mm, 171 parts (81 on the bottom side), 154 nets.
