HMS-RIC/Teensy-Breakout/(notices)

Notices in the files:
parts and their libraries:
SparkFun-Connectors: Licensing: Creative Commons ShareAlike 4.0 International - https://creativecommons.org/licenses/by-sa/4.0
rc-master: Copyright (C) 2007-2008, Bob Starr
op-amp: Copyright (C) 2015, Bob Starr
con-fci-quickie: Copyright (C) 2008, Bob Starr
